Ore19095/trabajo_de_graduacion/trabajo_de_graduación/n-anexos.tex

\section{Diagrama esquemático de la placa de expansión}
\label{sec:anexo_esquematico}

\begin{figure}[H]
    \centering
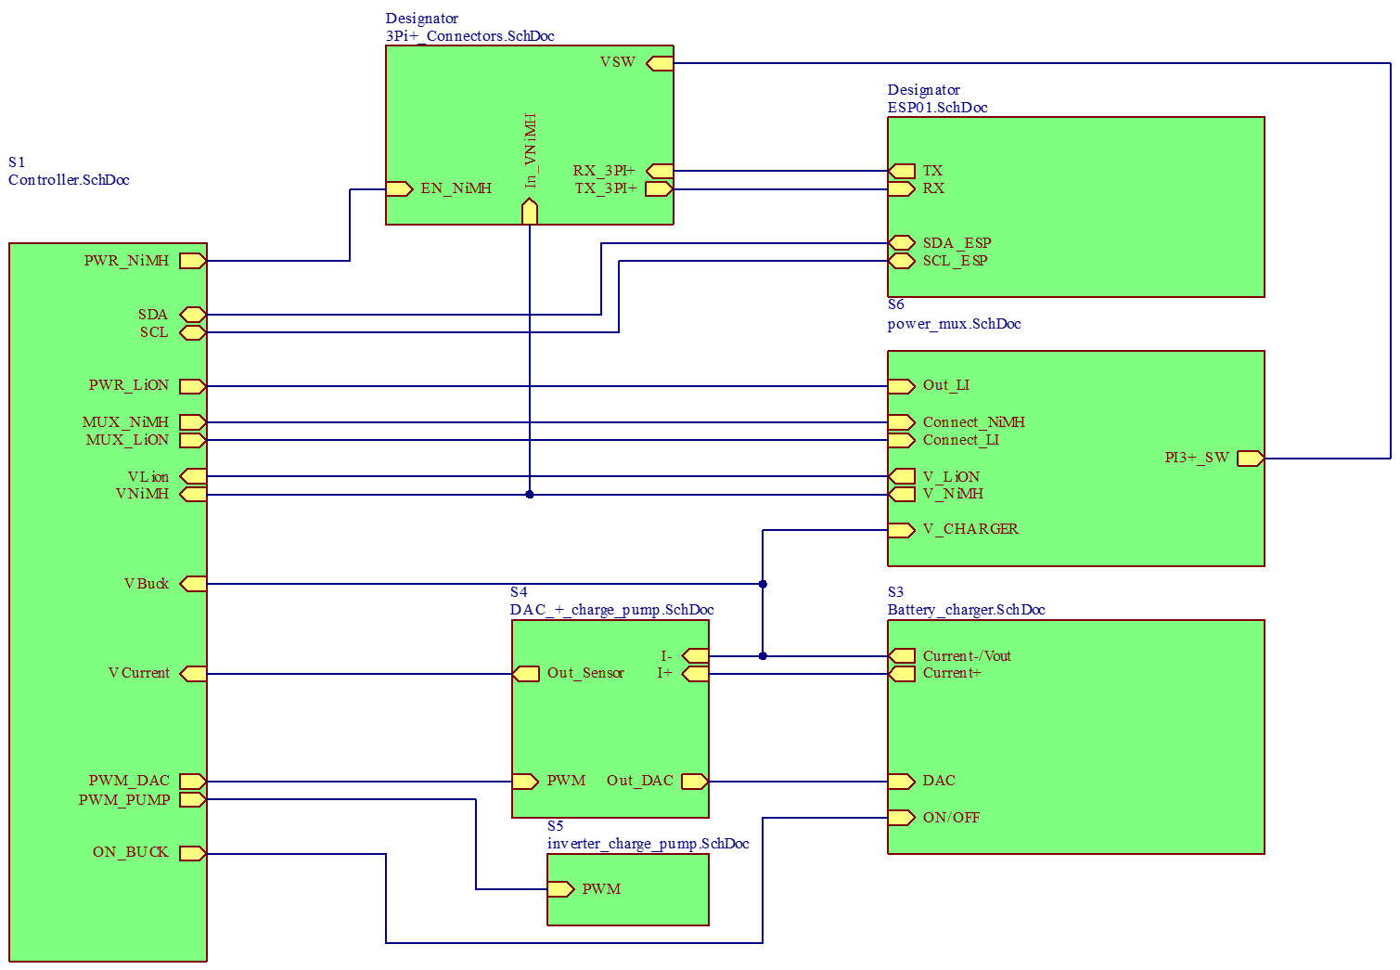
[picture p24: trabajo_de_graduación/imagenes/system_interconection.png]
    
    \caption{Interconexión de los circuitos en la placa de expansión}
    \label{fig:all}    
\end{figure}

\begin{figure}[H]
    \centering
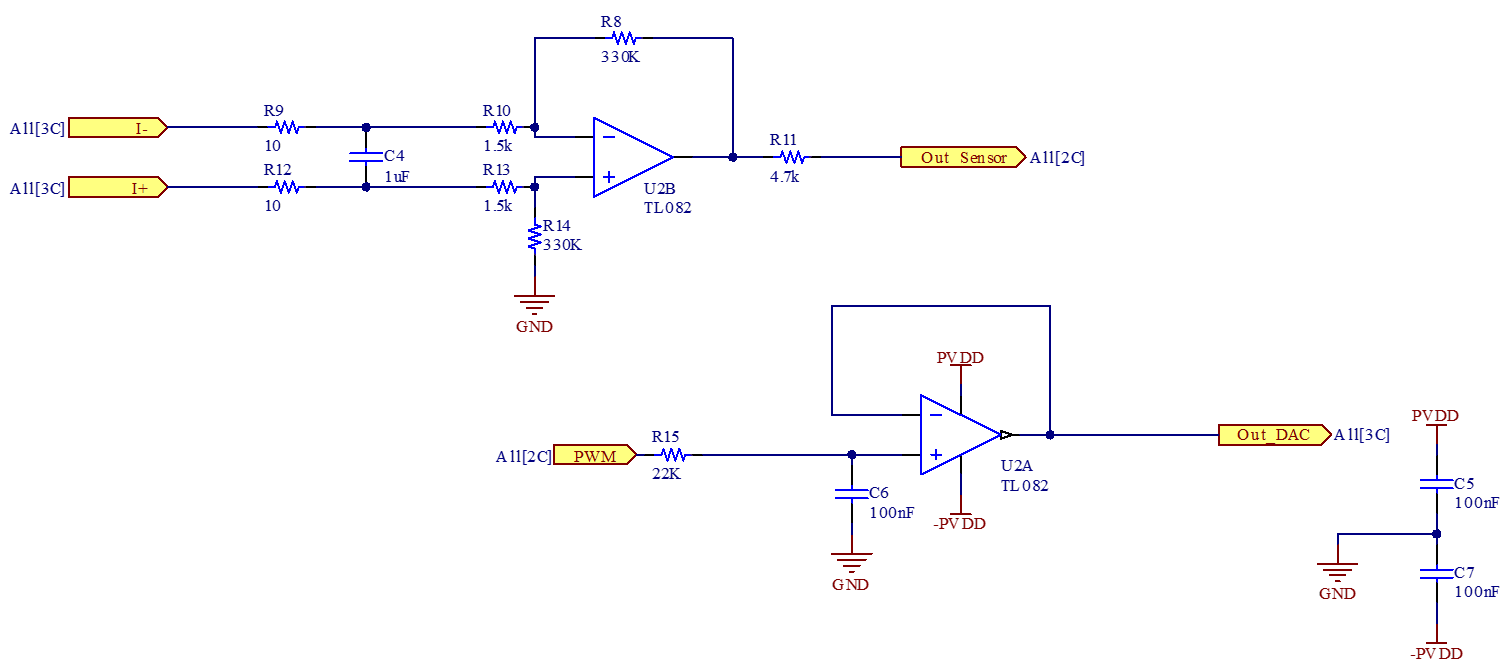
[picture p25: trabajo_de_graduación/imagenes/dac_sensor.png]
    
    \caption{Diagrama esquemático del sensor de corriente y el convertidor digital a analógico
    (S4 en la figura \ref{fig:all})}
    \label{fig:dac_sensor}
\end{figure}

\begin{figure}[H]
    \centering
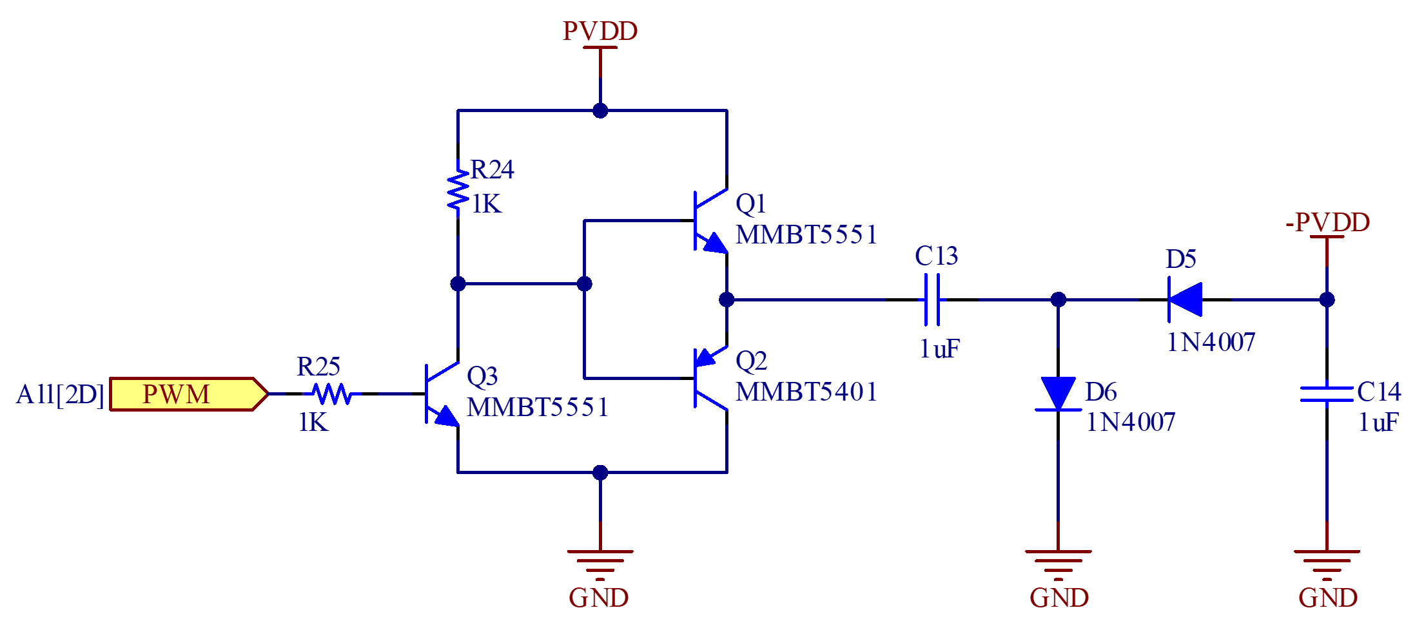
[picture p26: trabajo_de_graduación/imagenes/charge_pump.png]
    
    \caption{Diagrama esquemático del \textit{charge pump} (S5 en la figura \ref{fig:all})}
    \label{fig:charge_pump_anexo}
\end{figure}

\begin{figure}[H]
    \centering
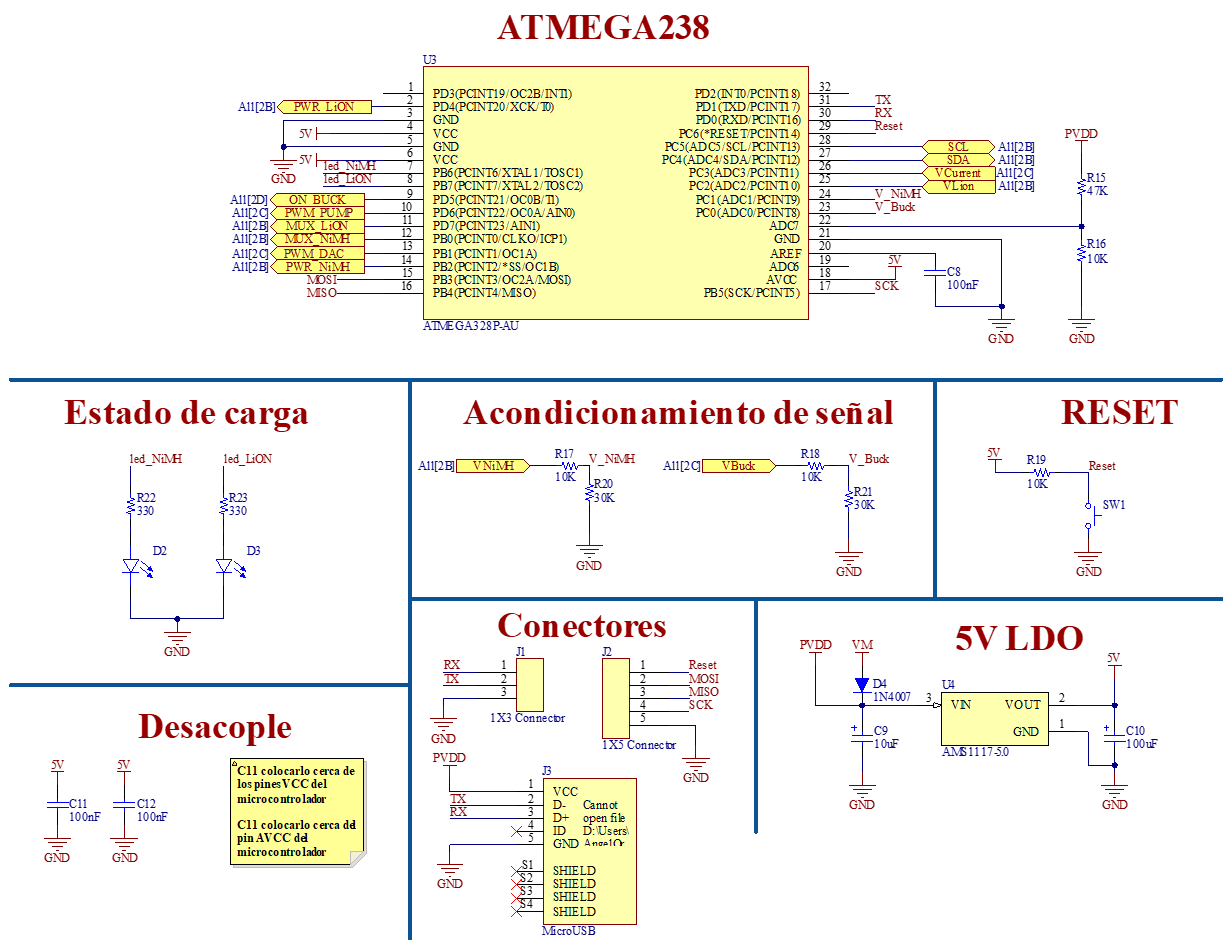
[picture p27: trabajo_de_graduación/imagenes/controlador_disenio.png]
    
    \caption{Diagrama esquemático del controlador (S1 en la figura \ref{fig:all})}
    \label{fig:controlador_anexo}
\end{figure}

\begin{figure}[H]
    \centering
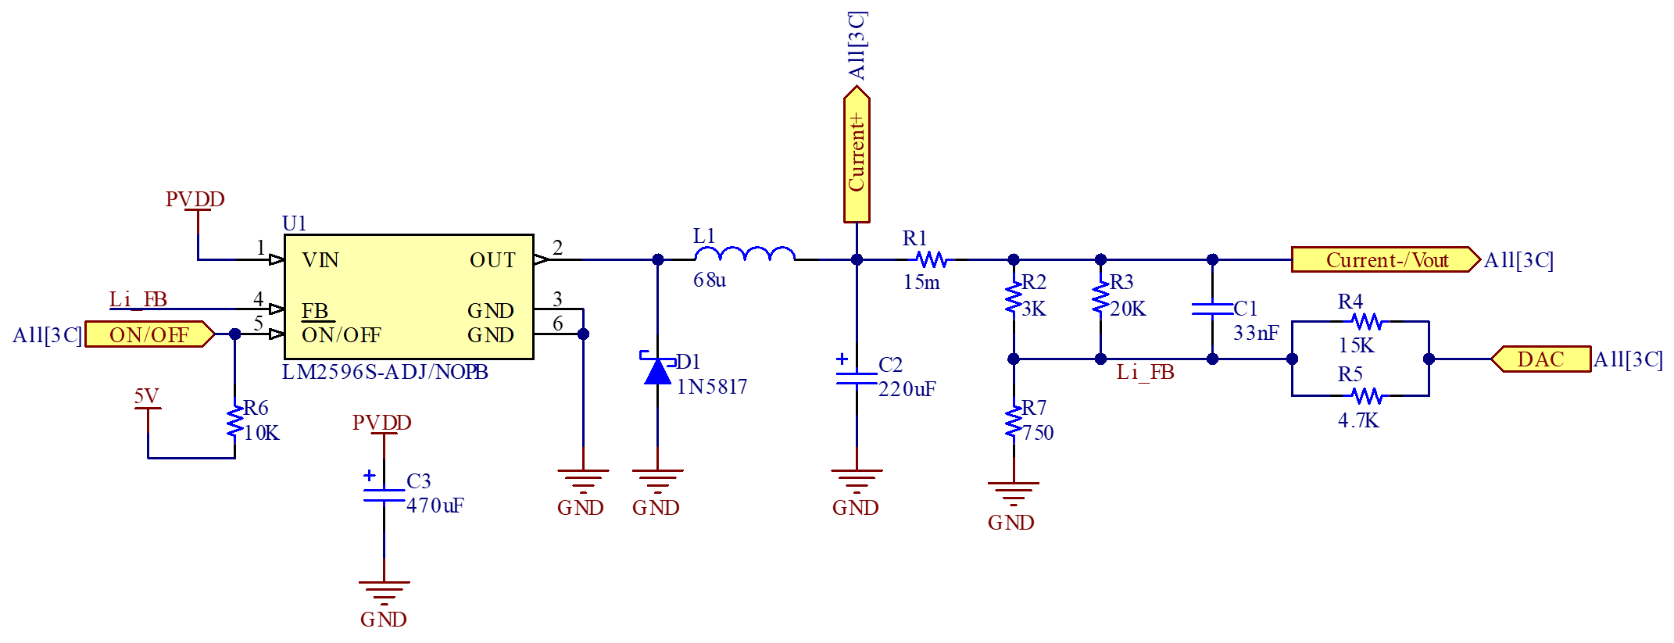
[picture p28: trabajo_de_graduación/imagenes/charger_anexos.png]
    
    \caption{Diagrama esquemático del convertidor reductor (S3 en la figura \ref{fig:all})}
    \label{fig:charger_anexo}
\end{figure}

\begin{figure}[H]
    \centering
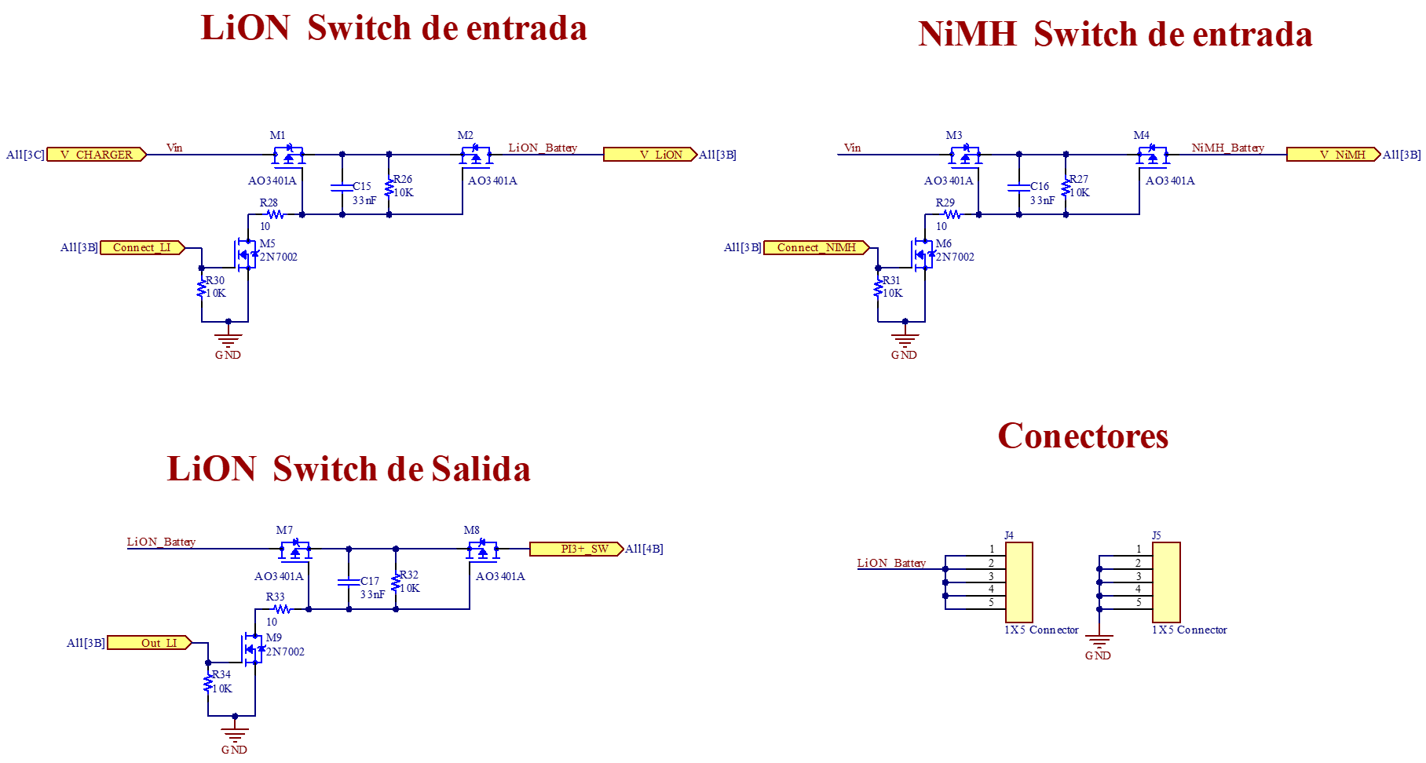
[picture p29: trabajo_de_graduación/imagenes/mux_anexo.png]
    
    \caption{Diagrama esquemático del multiplexor de potencia (S6 en la figura \ref{fig:all})}
    \label{fig:charger_anexo_mux}  
\end{figure}

\begin{figure}[H]
    \centering
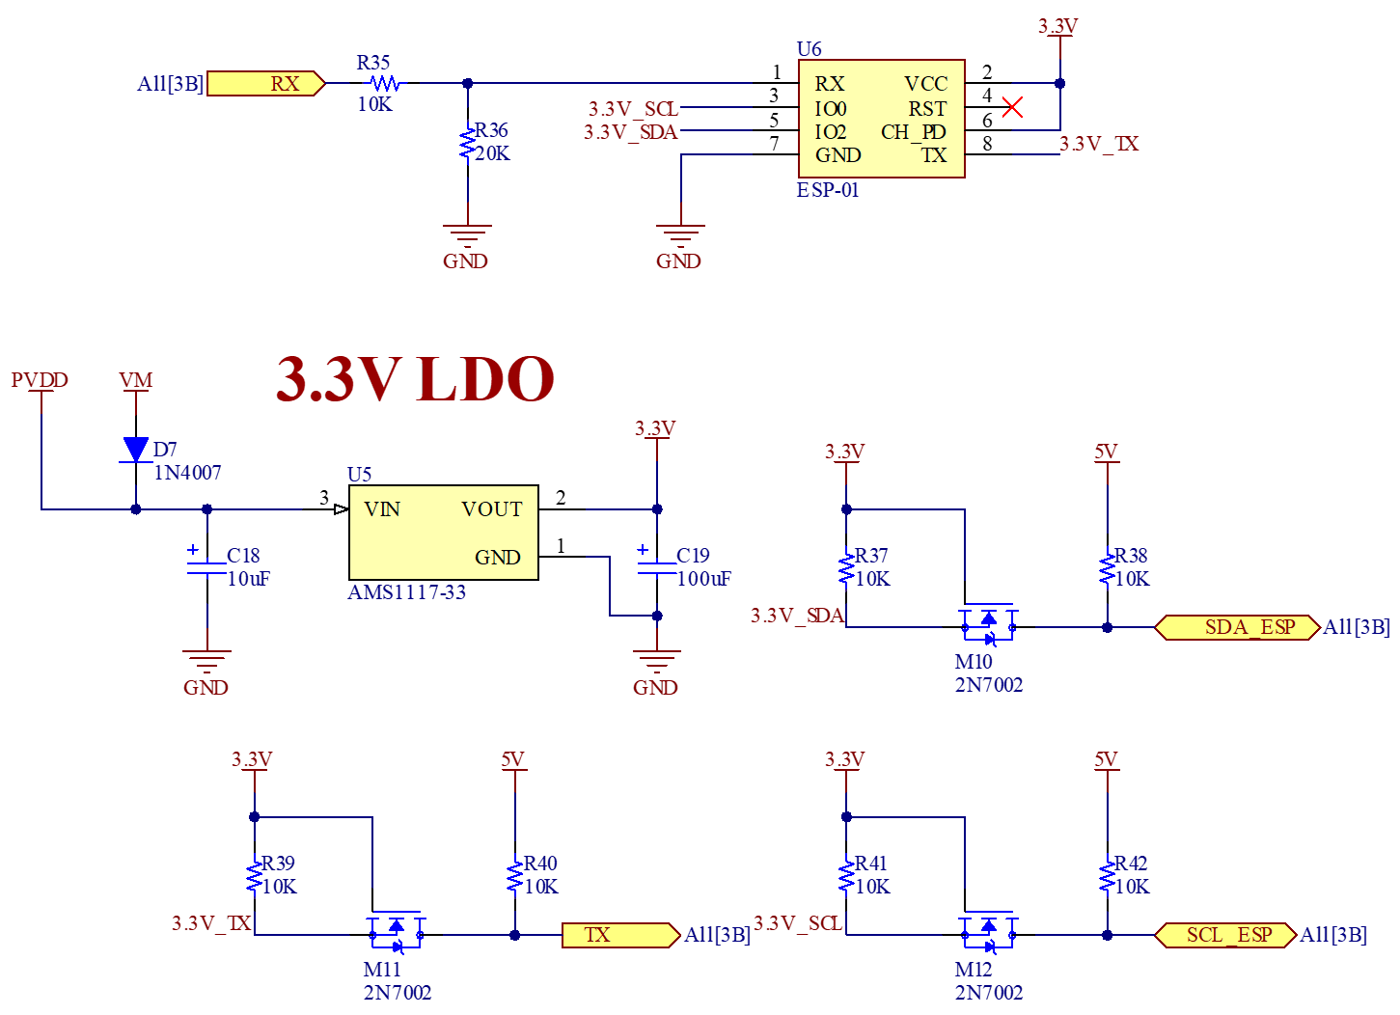
[picture p30: trabajo_de_graduación/imagenes/esp01.png]
    
    \caption{Diagrama esquemático del ESP01}
    \label{fig:esp01_anexo}
\end{figure}

\begin{figure}[H]
    \centering
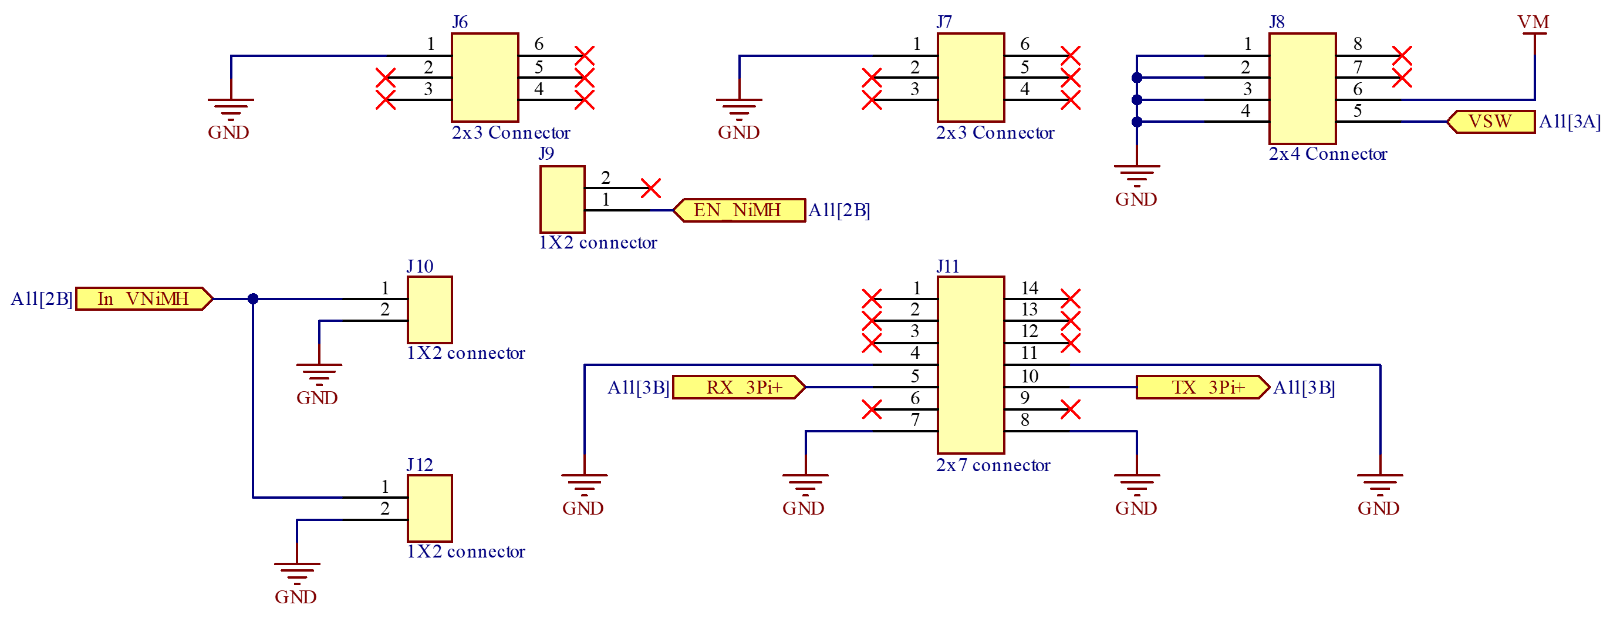
[picture p31: trabajo_de_graduación/imagenes/3pi+_anexo.png]
    
    \caption{Diagrama esquemático para los conectores del 3Pi+}
    \label{fig:3pi+_anexo}
\end{figure}

\section{Código fuente empleado en la prueba del DAC}

\label{sec:codigo_dac}

\lstinputlisting[style=atmega328]{../Charge_system_firmware/DAC_test.X/main.c}
\begin{table}[H]
    \caption{Código para prueba de funcionamiento del DAC}
\end{table}

\section{Código fuente empleado en la prueba de funcionamiento de la placa de expansión}
\label{sec:codigo_prueba_expansion}
\lstinputlisting[style=atmega328]{../Charge_system_firmware/Pololu_on_test.X/mian.c}
\begin{table}[H]
    \caption{Código para prueba de funcionamiento de la placa de expansión}
\end{table}

\section{Código fuente para el sistema de carga}
\label{sec:codigo_expansion}

\lstinputlisting[style=atmega328]{../Charge_system_firmware/Charging_system.X/main.c}
\begin{table}[H]
    \caption{Código para el sistema de carga}
\end{table}
