Ore19095/trabajo_de_graduacion/trabajo_de_graduación/sistema_carga_multiplicador_voltaje.tex

\section{Multiplicador de Voltaje}

    Debido a que el sensor de corriente y el DAC diseñados necesitan una
    alimentación simétrica de $\pm 7\text{V}$ (como mínimo), se diseñó 
    un multiplicador de voltaje basado en el circuito \textit{negative 
    Dickson charge pump} presentado en la sección \ref{sec:charge_pump}.

    \subsection{Señal de entrada del multiplicador de voltaje}
    
    Puesto que el multiplicador de voltaje necesita de una señal cuadrada, se utilizó un inversor
    elaborado con un transistor BJT, en cascada con una etapa de salida 
    \textit{push-pull}. El inversor es empleado para generar una señal
    cuadrada de amplitud $12\text{V}$ a partir de una señal cuadrada 
    de $5\text{V}$, mientras que la etapa \textit{push-pull}
    es utilizada para aumentar la corriente de salida del inversor, de forma
    que sea capaz de alimentar el multiplicador de voltaje. El circuito
    se muestra en la figura \ref{fig:inversor}.
    
    \begin{figure}[H]
        \centering
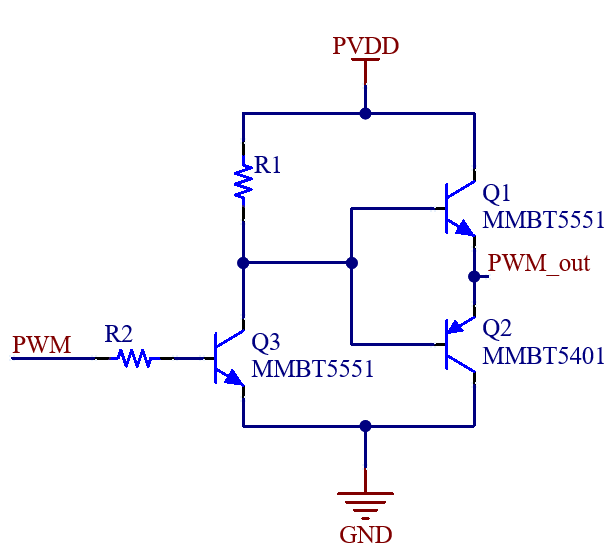
[picture p43: trabajo_de_graduación/imagenes/clk_gen.png]
        
        \caption{Inversor utilizado para generar la señal cuadrada}
        \label{fig:inversor}
    \end{figure}

    Para determinar los valores de $R_1$ y $R_2$
    se asumió que el voltaje entre base y emisor ($v_{be}$) del transistor $Q_3$
    es de $1\text{V}$  y que la ganancia en corriente del 
    transistor $Q_3$ es de $10$ \cite{mmtb5551}. Con lo anterior, se fijó el 
    valor de $R_2$ en $1\text{K}\Omega$, por 
    lo que la corriente en la base de $Q_3$ es de $I_b = 4\text{mA}$, y el valor
     esperado para la corriente de colector es de $I_c = 40\text{mA}$.

    Para que el transistor $Q_3$ actúe como un inversor es necesario que 
    este se encuentre alternando entre
    las regiones de corte y saturación. Para asegurar este comportamiento es necesario
    que el producto $I_cR_1$ sea mayor al voltaje en el nodo PVDD, el cual
    es de $12\text{V}$:
    
    $$
        I_cR_1 > 12\text{V}
    $$

    $$
        R_1 > \frac{12\text{V}}{40\text{mA}} = 300 \Omega
    $$

    Por lo que se utilizó un valor de $R_1 = 1\text{K}\Omega$. Esta señal es 
    pasada en la etapa \textit{push-pull} para aumentar la corriente de salida
    del inversor, así como disminuir la impedancia, de forma que sea 
    capaz de alimentar el multiplicador de voltaje.

    \subsection{Diseño del multiplicador de voltaje}

    Para el diseño del multiplicador de voltaje se estableció que la 
    el valor de $C_1$ y $C_2$ sea de
    $1\mu\text{F}$, que el valor de salida requerido debe ser menor o igual
    a $-7\text{V}$ y el número de etapas($N$) es igual a 1. En la 
    ecuación \ref{eq:dickson_charge_neg}  se toma en cuenta la
    capacitancia parásita de los diodos ($C_s$), para el diseño se asumió
    que estas capacitancias no son significativas en comparación con 
    $C_1$ y $C_2$,por lo que se asume $C_s = 0$.
    Con lo anterior, la ecuación \ref{eq:charge_pump} se simplifica a la
    ecuación \ref{eq:charge_pump_simp}. En la figura \ref{fig:charge_pump_dis}
    se muestra el circuito diseñado.

    \begin{figure}[H]
        \centering
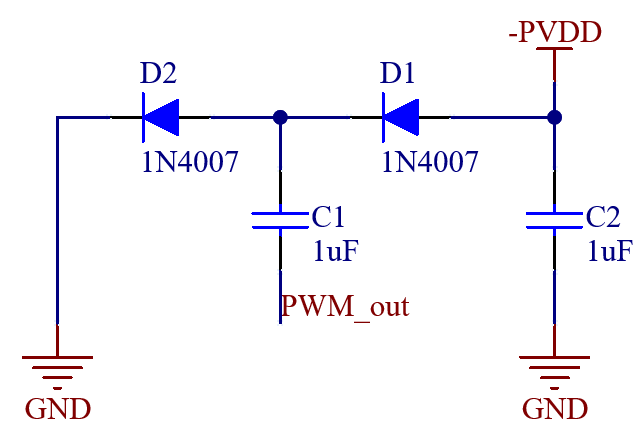
[picture p44: trabajo_de_graduación/imagenes/dickson_charge.png]
        
        \caption{Circuito diseñado para el multiplicador de voltaje}
        \label{fig:charge_pump_dis}
    \end{figure}

    \begin{equation}
        V_{out} = -\left(V_\Phi - V_D - \frac{I_{out}}{Cf}  \right) + V_D
        \label{eq:charge_pump_simp}
    \end{equation}

    Para determinar la frecuencia de operación, se utilizó la ecuación 
    \ref{eq:charge_pump_simp}, junto con la desigualdad 
    $V_{out} \leq -7\text{V}$, obteniendo la ecuación 
    \ref{eq:charge_pump_simp2}.

    \begin{equation}
        -\left(V_\Phi - V_D - \frac{I_{out}}{Cf}\right) + V_D \leq -7\text{V}
        \label{eq:charge_pump_simp2}    
    \end{equation}

    Para la amplitud de la señal cuadrada se utilizó el valor de 
    $V_\Phi = 12 \text{V}$, mientras que para 
    el valor de $V_D$ se utilizó el valor de $0.7\text{V}$, y se estimó que
    la corriente de salida del multiplicador de voltaje es de $10\text{mA}$.
    Despejando para la frecuencia se obtiene la ecuación \ref{eq:charge_pump_simp3}.

    \begin{equation}
        f \geq \frac{I_{out}}{C(V_\Phi - 2V_D - V_{out})}
        \label{eq:charge_pump_simp3}
    \end{equation}

    Reemplazando los valores estimados anteriormente en la ecuación \ref{eq:charge_pump_simp3} se obtiene
    la frecuencia de operación del multiplicador de voltaje debe de ser 

        $$
            f \geq \frac{10\text{mA}}{1\mu\text{F}(12\text{V} - (2)0.7\text{V}
             - 7\text{V})} \approx 2.778\text{KHz}
        $$

    Ya que este es un valor mínimo para la frecuencia de operación, al utilizar
    una frecuencia mayor se obtendrá un voltaje de salida mayor, por lo que se
    utilizó una frecuencia de operación de $7.81\text{KHz}$, la cual es la
    frecuencia de la señal PWM generada por el microcontrolador.

    \subsection{Prueba física del multiplicador de voltaje}

    Para comprobar el correcto funcionamiento del multiplicador de voltaje
    se añadió el multiplicador de voltaje diseñado, a los circuitos de prueba
    del DAC, el sensor de corriente  y convertidor reductor. En la figura
    \ref{fig:prueba_multiplicador} se muestra el circuito armado en protoboard.
    
    \begin{figure}[H]
        \centering
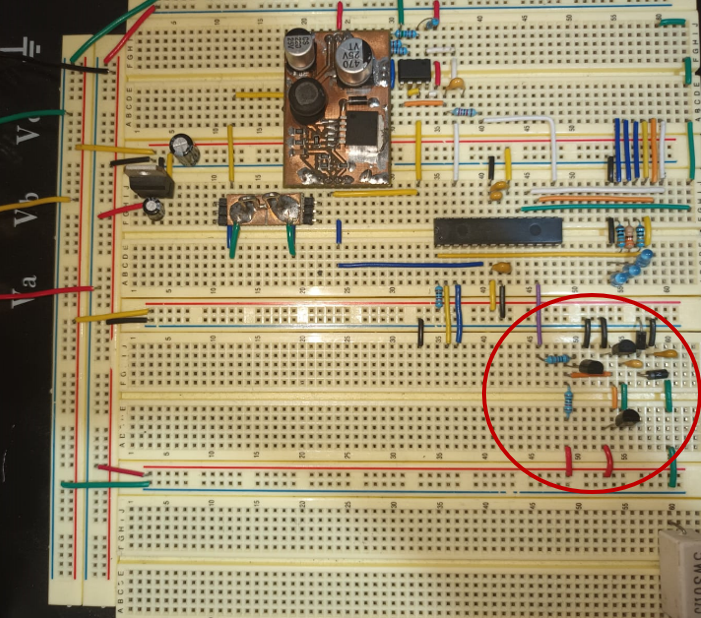
[picture p45: trabajo_de_graduación/imagenes/prueba_multiplicador.png]
        
        \caption{Circuito armado para la prueba del multiplicador de voltaje}
        \label{fig:prueba_multiplicador}
    \end{figure}

    Con el circuito armado se midió el voltaje de salida del multiplicador
    de voltaje, en las figuras \ref{fig:out_multiplicador_load} y \ref{fig:out_multiplicador_no_load}
    se muestra el voltaje de salida del multiplicador de voltaje con y sin carga,
    respectivamente.

    \begin{figure}[H]
        \centering

        \begin{subfigure}{0.45\textwidth}
            \centering
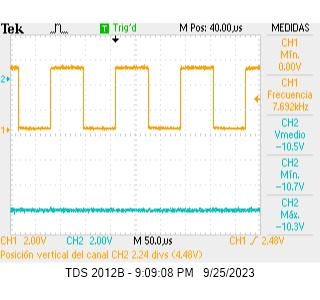
[picture p46: trabajo_de_graduación/imagenes/negative_charge_no_load.jpg]
            
            \caption{Sin carga}
            \label{fig:out_multiplicador_no_load}
        \end{subfigure}
        \begin{subfigure}{0.45\textwidth}
            \centering
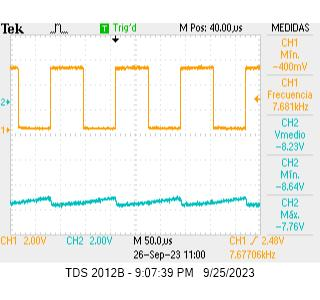
[picture p47: trabajo_de_graduación/imagenes/negative_charge_load.jpg]
            
            \caption{Con carga}
            \label{fig:out_multiplicador_load}
        \end{subfigure}
        \caption{Voltaje de salida del multiplicador de voltaje (azul, salida del multiplicador de voltaje, naranja señal cuadrada
        de entrada)}
    \end{figure}
    
    en la figura \ref{fig:out_multiplicador_no_load} se puede observar que
    el voltaje de salida del multiplicador de voltaje es de $-10.5\text{V}$ en 
    promedio, mientras que en la figura \ref{fig:out_multiplicador_load} se
    puede observar que el voltaje de salida del multiplicador de voltaje es de
    $-8.23\text{V}$ en promedio. Este resultado es el esperado, ya que el
    cuando se le coloca una carga al multiplicador de voltaje, la corriente
    de salida hace que el voltaje de salida disminuya, como es indicado en la 
    ecuación \ref{eq:charge_pump_simp}.

    Sabiendo que los diodos utilizados en el multiplicador de voltaje tienen
    una caída de voltaje de $0.7\text{V}$, se puede calcular el voltaje de
    salida del multiplicador de voltaje, utilizando la ecuación \ref{eq:charge_pump_simp}.
    Con la cual se espera que el voltaje de salida del multiplicador de voltaje
    al no haber carga sea de $-10.6\text{V}$, mientras que al haber carga, con
    una frecuencia de operación de $7.81\text{KHz}$, se espera que el voltaje
    de salida del multiplicador de voltaje sea de $-9.3\text{V}$, caso en el 
    cual se obtuvo un voltaje de $-8.23\text{V}$.
    
    La razón por la cual el voltaje de salida del multiplicador de voltaje es menor al esperado,
     es debido a varios factores: la tolerancia de los capacitores empleados, el voltaje de 
    base a colector en saturación de los transistores BJT, una mayor caída de voltaje en los diodos,
    entre otros. Sin embargo, el voltaje de salida del multiplicador de voltaje
    es suficiente para alimentar el sensor de corriente y el DAC, al ser
    menor a $-7\text{V}$, y puesto que el amplificador operacional empleado no 
    opera cerca de los valores de saturación, el ruido por conmutación
    de los transistores BJT no afecta al funcionamiento del sensor de corriente
    ni del DAC.
