Ore19095/trabajo_de_graduacion/trabajo_de_graduación/l-recomendaciones.tex

\begin{itemize}
    \item Para tener una mejor precisión en la medición de la corriente, evitar el uso
    de fuentes de voltaje negativos y reducir el espacio utilizado por el
    circuito de medición de corriente,
    se recomienda utilizar una resistencia con una menor tolerancia en empaquetado SMD, así como un 
    circuito integrado dedicado para medir corriente como lo puede ser el INA219, 
    o el INA190 de Texas Instruments.

    \item Utilizar un microcontrolador que posea un periférico de comunicación USB nativo,
    para evitar el uso de conversores USB a UART y poder hacer la placa de expansión
    compatible con protocolos de carga rápida como lo es el USB \textit{Power Delivery}, o el
    \textit{Quick Charge} de Qualcomm

    \item Emplear un circuito integrado dedicado que realice la función de 
    convertidor digital a analógico, para reducir el espacio utilizado en la placa
    de expansión, así como mejorar la precisión de la señal de voltaje para el control
    del convertidor reducir.

\end{itemize}
