Ore19095/trabajo_de_graduacion/trabajo_de_graduación/trabajo_de_graduacion_Angel_Orellana.tex

% Se pre-carga la información del estudiante sólo para poder emplear el macro de
% selección de versión (digital o impresa)
\input{0-datos_estudiante}

\ifdefined\printver
    \documentclass[11pt, letterpaper, twoside, openright]{report}
\else
    \documentclass[11pt, letterpaper]{report}
\fi

% Eliminar la opción de twoside y openright si se desea generar la versión
% digital del documento en lugar de la versión impresa
%\documentclass[11pt, letterpaper, twoside, openright]{report}
\usepackage[spanish, es-nodecimaldot, es-noquoting]{babel}
% cambiar a spanish, mexico si se quiere emplear tabla en lugar de cuadro
\selectlanguage{spanish}
\usepackage[utf8]{inputenc}
\usepackage[T1]{fontenc}

\title{Plantilla para Trabajos de Graduación IE-MT 2019v4}
\author{MSc. Miguel Zea}
\date{\today}

% Información del estudiante en el archivo datos_estudiante.tex
\input{0-datos_estudiante}
\input{1-opciones_adicionales}

% ==============================================================================
% DEFINICIÓN DE PAQUETES
% ==============================================================================
\usepackage{xcolor}
\usepackage{amsfonts}
\usepackage{amsmath}
\usepackage{amssymb}
\usepackage{amsthm}
\usepackage{amsfonts}
\usepackage{mathtools}
\usepackage{graphicx}
\usepackage{xfrac}
\usepackage{float}
\usepackage{mathtools}
\usepackage[hypertexnames=false]{hyperref}
% \usepackage{bookmark}
\usepackage[font=small]{caption}
\usepackage{subcaption}
\usepackage{csquotes}
\usepackage{xpatch}
\usepackage{emptypage}
\usepackage{hyphenat}
\usepackage{fancyhdr}
\usepackage[backend=biber, style=ieee]{biblatex}
\addbibresource{m-bibliografias.bib}

\usepackage[percent]{overpic}

\usepackage{chngcntr}

\ifdefined\CAPglosario
	%\usepackage[toc]{glossaries}
	\usepackage[numberedsection]{glossaries}
	\makeglossaries
    \input{o-glosario}
\fi

% ==============================================================================
% MÁRGENES Y FORMATO GENERALES
% ==============================================================================
\usepackage[top=1in, left=1.5in, right=1in, bottom=1in]{geometry}
%Options: Sonny, Lenny, Glenn, Conny, Rejne, Bjarne, Bjornstrup
\usepackage[Sonny]{fncychap}

% ==============================================================================
% DEFINICIONES DE LA PLANTILLA
% ==============================================================================
\graphicspath{ {figuras/} }
\definecolor{uvg-green}{RGB}{17,71,52}
\newcommand{\defaultparformat}[1]{
	{\setlength{\parskip}{2ex}
     \input{#1}}
}
\ifdefined\capsecuvg
	\renewcommand\thechapter{\Roman{chapter}}
    \renewcommand\thesection{\Alph{section}}
	\renewcommand\thesubsection{\arabic{subsection}}
    \renewcommand\thesubsubsection{\alph{subsubection}}
\fi
\counterwithout{figure}{chapter}
\counterwithout{table}{chapter}
\counterwithout{equation}{chapter}

\newcommand{\blankpage}{
\newpage
\thispagestyle{empty}
\mbox{}
\newpage
}
% ==============================================================================

% Comandos definidos por el usuario en el archivo comandos_usuario.tex
\input{2-paquetes_y_comandos_usuario}

% ==============================================================================
% CUERPO DEL TRABAJO
% ==============================================================================
\pagestyle{headings}
\begin{document}

% ==============================================================================
% PORTADA
% ==============================================================================
\ifdefined\printver
    \let\CAPportada\undefined
\fi 

\ifdefined\CAPportada
    \cleardoublepage\phantomsection
    % \pdfbookmark{Portada}{toc}
	\newgeometry{left=3cm, bottom=0in, top=1in, right=3cm}
	\pagecolor{uvg-green}
	\thispagestyle{empty}

	\color{white}
	\noindent \hrulefill \par
	\vspace{0.1in}
	\noindent \Huge \nohyphens{\titulotesis} \par
	\noindent \hrulefill \par
	\noindent
	\LARGE \nombreestudiante

	\begin{figure}[b!]
    	%\makebox[\textwidth]{\includegraphics[height=13.25cm]{plantilla/portadacit.jpg}}
    	\makebox[\textwidth]{
    		\begin{overpic}[height=13.25cm]{\imagenportada}
     		\put(63,0){}  
  			\put(64.5,2){} 
        	\end{overpic}
    	}
    	%\includegraphics[height=13.25cm]{plantilla/portadacit.jpg}
	\end{figure}
	\restoregeometry
\fi

% ==============================================================================
% PRIMERAS PÁGINAS (Carátulas más hojas de guarda)
% ==============================================================================
\ifdefined\CAPcaratula
	\newpage
    \cleardoublepage\phantomsection
    % \pdfbookmark{Carátula}{toc}
	\pagecolor{white}
	\color{black}
	\setcounter{page}{1}
	\pagenumbering{roman}
	\thispagestyle{empty}
	\begin{center}
		\LARGE UNIVERSIDAD DEL VALLE DE GUATEMALA\\
		\LARGE Facultad de \uvgfacultad \\[0.75cm]
	\end{center}
	\begin{figure}[h]
		\begin{center}
		
		\vspace{0.5in}
		\end{center}
	\end{figure}
	\begin{center}
		\Large \textbf{\nohyphens{\titulotesis}} \\
		%\LARGE \textbf{\titulotesis} \\
		\vfill
		\Large \nohyphens{Trabajo de graduación presentado por \nombreestudiante \ para optar al grado académico de Licenciado en \uvgcarrera} \\
		\vfill
		\large Guatemala, \\
		\vspace{1em}
		\anoentrega
	\end{center}
    
    \ifdefined\printver	
	    \blankpage
	    \blankpage
	    
	    \newpage
	    \cleardoublepage\phantomsection
	    \pagecolor{white}
    	\color{black}
    	\setcounter{page}{1}
    	\pagenumbering{roman}
    	\thispagestyle{empty}
    	\begin{center}
    		\LARGE UNIVERSIDAD DEL VALLE DE GUATEMALA\\
    		\LARGE Facultad de \uvgfacultad \\[0.75cm]
    	\end{center}
    	\begin{figure}[h]
    		\begin{center}
    		
    		\vspace{0.5in}
    		\end{center}
    	\end{figure}
    	\begin{center}
    		\Large \textbf{\nohyphens{\titulotesis}} \\
    		%\LARGE \textbf{\titulotesis} \\
    		\vfill
    		\Large \nohyphens{Trabajo de graduación presentado por \nombreestudiante \ para optar al grado académico de Licenciado en \uvgcarrera} \\
    		\vfill
    		\large Guatemala, \\
    		\vspace{1em}
    		\anoentrega
    	\end{center}
    \fi
\fi

% ==============================================================================
% HOJA DE FIRMAS
% ==============================================================================
\ifdefined\CAPfirmas
	\newpage
	\cleardoublepage\phantomsection
	\thispagestyle{empty}
	\vspace*{0.5in}
	\large Vo.Bo.:\\[1cm]
	\begin{center}
		(f) \rule[1pt]{4 in}{1pt}\\
		\nombreasesor
	\end{center}
	\vspace{1in}

	Tribunal Examinador:\\[1cm]
	\begin{center}
		(f) \rule[1pt]{4 in}{1pt}\\
		\nombreasesor \\[1in]
		(f) \rule[1pt]{4 in}{1pt}\\
		\nombreprimerex \\[1in]
		(f) \rule[1pt]{4 in}{1pt}\\
		\nombresegundoex
	\end{center}
	\vspace{1in}

%	Fecha de aprobación: Guatemala, \rule[1pt]{0.5 in}{1pt} de \rule[1pt]{1 in}{1pt} de \anoaprobacion.
    Fecha de aprobación: Guatemala,\diaaprobacion de \mesaprobacion de \anoaprobacion. %\diaaprobacion de \mesaprobacion de \anoaprobacion.
	\normalsize
\fi

% Comentar para formato estilo libro en la numeración de páginas (NO 
% compatible con la guía UVG 2019)
\pagestyle{plain}
% ==============================================================================
% CONTENIDO DEL TRABAJO
% ==============================================================================
% PREFACIO
% ------------------------------------------------------------------------------
\ifdefined\CAPprefacio
	\newpage
	\cleardoublepage\phantomsection
    \chapter*{Prefacio}
    \ifdefined\parpordefecto
    	\defaultparformat{a-prefacio}
    \else
    	\input{a-prefacio}
    \fi
    \addcontentsline{toc}{chapter}{Prefacio}
\fi

% ÍNDICE GENERAL
% ------------------------------------------------------------------------------
\ifdefined\CAPindice
	\newpage
    \cleardoublepage\phantomsection
	\renewcommand{\contentsname}{Índice}
    %\phantomsection
    \pdfbookmark{\contentsname}{toc}
    %\pdfbookmark{Índice}{toc}
	\tableofcontents
\fi

% LISTADO DE FIGURAS
% ------------------------------------------------------------------------------
\ifdefined\CAPfiguras
	\newpage
    \cleardoublepage\phantomsection
	\renewcommand{\listfigurename}{Lista de figuras}
	\listoffigures
	\addcontentsline{toc}{chapter}{Lista de figuras}
\fi

% LISTADO DE CUADROS
% ------------------------------------------------------------------------------
\ifdefined\CAPcuadros
	\newpage
    \cleardoublepage\phantomsection
	\renewcommand{\listtablename}{Lista de cuadros}
	\listoftables
	\addcontentsline{toc}{chapter}{Lista de cuadros}
\fi

% RESUMEN
% ------------------------------------------------------------------------------
\ifdefined\CAPresumen
	\newpage
    \cleardoublepage\phantomsection
	\chapter*{Resumen}
	\ifdefined\parpordefecto
		\defaultparformat{b-resumen}
	\else
		\input{b-resumen}
	\fi
	\addcontentsline{toc}{chapter}{Resumen}
\fi

% ABSTRACT
% ------------------------------------------------------------------------------
\ifdefined\CAPabstract
	\newpage
    \cleardoublepage\phantomsection
	\chapter*{Abstract}
	\ifdefined\parpordefecto
		\defaultparformat{c-abstract}
	\else
		\input{c-abstract}
	\fi
	\addcontentsline{toc}{chapter}{Abstract}
\fi

% INTRODUCCIÓN
% ------------------------------------------------------------------------------
\ifdefined\CAPintroduccion
	\newpage
	\cleardoublepage
	\pagenumbering{arabic}
	\setcounter{page}{1}
	\chapter{Introducción}
	\ifdefined\parpordefecto
		\defaultparformat{d-introduccion}
	\else
		\input{d-introduccion}
	\fi
\fi

% ANTECEDENTES
% ------------------------------------------------------------------------------
\ifdefined\CAPantecedentes
	\newpage
	\chapter{Antecedentes}
	\ifdefined\parpordefecto
    	\defaultparformat{e-antecedentes}
    \else
    	\input{e-antecedentes}
    \fi  
\fi

% JUSTIFICACIÓN
% ------------------------------------------------------------------------------
\ifdefined\CAPjustificacion
	\newpage
	\chapter{Justificación}
	\ifdefined\parpordefecto
		\defaultparformat{f-justificacion}
	\else
		\input{f-justificacion}
	\fi
\fi

% OBJETIVOS
% ------------------------------------------------------------------------------
\ifdefined\CAPobjetivos
	\newpage
	\chapter{Objetivos}
	\ifdefined\parpordefecto
		\defaultparformat{g-objetivos}
	\else
		\input{g-objetivos}
	\fi
\fi

% ALCANCE
% ------------------------------------------------------------------------------
\ifdefined\CAPalcance
	\newpage
	\chapter{Alcance}
	\ifdefined\parpordefecto
    	\defaultparformat{h-alcance}
    \else
    	\input{h-alcance}
    \fi 
\fi

% MARCO TEÓRICO
% ------------------------------------------------------------------------------
\ifdefined\CAPmarcoteorico
	\newpage
	\chapter{Marco teórico}
	\ifdefined\parpordefecto
		\defaultparformat{i-marco_teorico}
	\else
		\input{i-marco_teorico}
	\fi
\fi

% CAPÍTULOS
% ------------------------------------------------------------------------------
\newpage
\ifdefined\parpordefecto
	\defaultparformat{j-capitulos}
\else
	\input{j-capitulos}
\fi

% CONCLUSIONES
% ------------------------------------------------------------------------------
\ifdefined\CAPconclusiones
	\newpage
	\chapter{Conclusiones}
	\ifdefined\parpordefecto
		\defaultparformat{k-conclusiones}
	\else
		\input{k-conclusiones}
	\fi
\fi

% RECOMENDACIONES
% ------------------------------------------------------------------------------
\ifdefined\CAPrecomendaciones
	\newpage
	\chapter{Recomendaciones}
	\ifdefined\parpordefecto
		\defaultparformat{l-recomendaciones}
	\else
		\input{l-recomendaciones}
	\fi
\fi

% BIBLIOGRAFÍA
% ------------------------------------------------------------------------------
\ifdefined\CAPbibliografia
	\newpage
    \cleardoublepage\phantomsection
	\chapter{\bibname}
    \printbibliography[heading=none]
\fi

% ANEXOS
% ------------------------------------------------------------------------------
\ifdefined\CAPanexos
	\newpage
	\chapter{Anexos}
	\ifdefined\parpordefecto
		\defaultparformat{n-anexos}
	\else
		\input{n-anexos}
	\fi
\fi

% GLOSARIO
% ------------------------------------------------------------------------------
\ifdefined\CAPglosario
	\newpage
	\printglossary
\fi

\end{document}
