Ore19095/trabajo_de_graduacion/trabajo_de_graduación/h-alcance.tex

El alcance de este proyecto se enfoca en el diseño e implementación
de un sistema de carga multiquímica capaz de gestionar la recarga
de baterías de iones de litio (Li-ion) y níquel-metalhidruro (NiMH).
El objetivo principal es mejorar significativamente la autonomía del agente
robótico Pololu 3Pi+ y simplificar el proceso de carga asociado a sus baterías.

Para lograr este propósito, se llevará a cabo la implementación de algoritmos
especializados, diseñados para detectar tanto el inicio como la finalización
de los procesos de carga específicos para cada tipo de batería.

En el marco de este diseño de carga, se incluye el diseño y construcción
de una estación de carga dedicada. Esta estación deberá ser capaz
de suministrar tanto el voltaje como la corriente
requerida para el funcionamiento óptimo del sistema de carga
multiquímica mencionado anteriormente.
