Ore19095/trabajo_de_graduacion/trabajo_de_graduación/a-prefacio.tex

Quiero comenzar este trabajo de graduación expresando mi agradecimiento a
quienes han sido fundamentales en mi carrera académica. A mi familia, por su
amor, sacrificio y apoyo constante a lo largo de este camino. A mi querida
novia, Janny Garcia, por su apoyo y consejos invaluables en los momentos
difíciles. A mis amigos, en especial a Daniel Mundo, Noel Prado, Julio
Lopez, Victor Vanegas, Angelo Machorro y Saúl de León, por su amistad y aliento
inquebrantable. Este trabajo de graduación es el resultado de años de esfuerzo 
y dedicación, y cada uno de ustedes ha tenido un papel importante en mi camino 
hacia la culminación de esta etapa académica. Finalmente, quiero agradecer a mi
universidad, a mis profesores y a todos aquellos que contribuyeron a mi 
formación académica. Con gratitud, les dedico este trabajo como una muestra
 de mi aprecio y reconocimiento por su apoyo continuo.
