Ore19095/trabajo_de_graduacion/trabajo_de_graduación/g-objetivos.tex

\subsection*{Objetivo General}

Desarrollar y manufacturar un sistema de carga multiquímica inteligente para los agentes robóticos 
Pololu 3Pi+.

\subsection*{Objetivos específicos}

\begin{itemize}
    \item Desarrollar y manufacturar una placa de expansión para los 
    agentes robóticos Pololu 3Pi+, que contenga un módulo de carga multiquímica
    y manejo de potencia.
    \item Implementar un sistema de carga multiquímica que logre el manejo de 
    un banco de baterías NiMH, así como una batería de respaldo adicional Li-ion 18650.
    \item  Desarrollar e implementar un algoritmo de monitoreo y diagnóstico para el uso
    automático de la batería de respaldo y la carga automática del agente. 
    \item Desarrollar el prototipo de la estación de carga para los agentes Pololu 3Pi+.

\end{itemize}
