Ore19095/trabajo_de_graduacion/trabajo_de_graduación/imagenes/buck_control.png

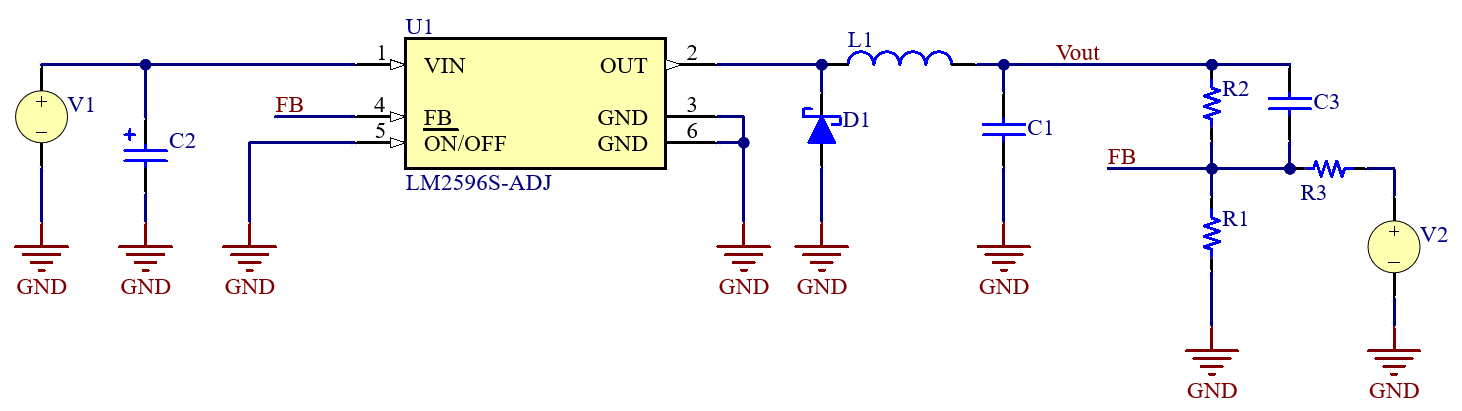
trabajo_de_graduación/imagenes/buck_control.png
