Ore19095/trabajo_de_graduacion/trabajo_de_graduación/imagenes/charger_pcb.jpg

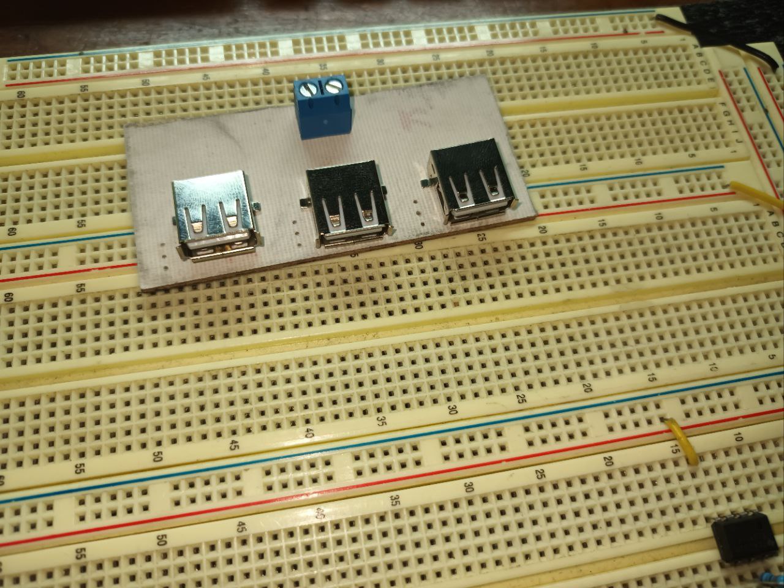
trabajo_de_graduación/imagenes/charger_pcb.jpg
