Ore19095/trabajo_de_graduacion/trabajo_de_graduación/imagenes/circuit_phis.png

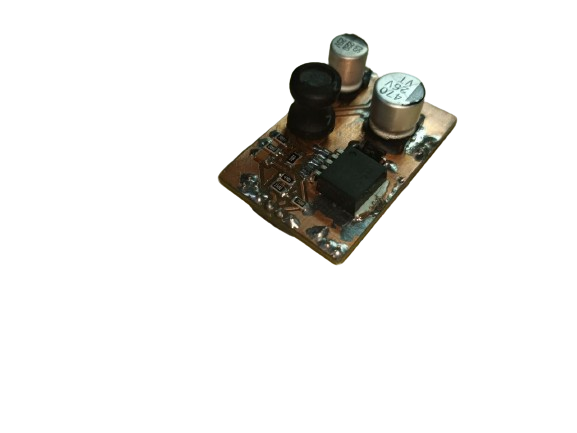
trabajo_de_graduación/imagenes/circuit_phis.png
