Ore19095/trabajo_de_graduacion/trabajo_de_graduación/imagenes/system_3d.png

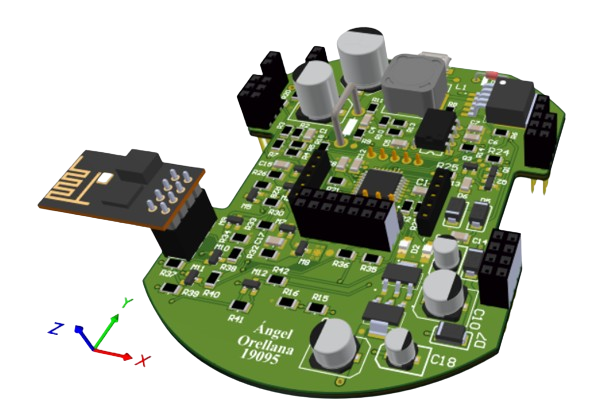
trabajo_de_graduación/imagenes/system_3d.png
