Ore19095/trabajo_de_graduacion/charging_station.3mf

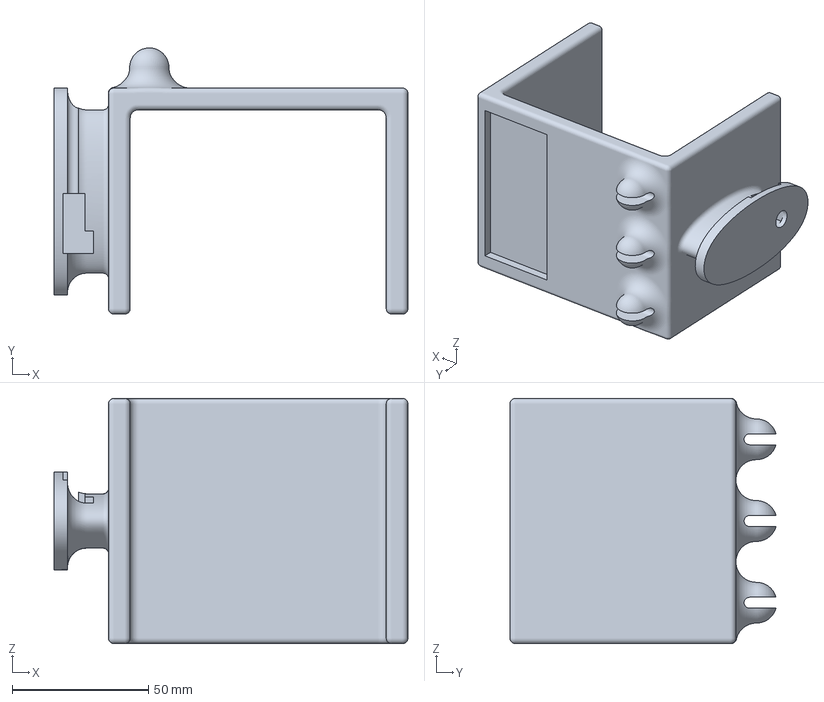
[picture p73: CAD file, 2023-11-26]
charging_station.3mf
130.0 x 97.7 x 90.0 mm
