Ore19095/trabajo_de_graduacion/PCB_Design/Battery_holde_esp32/battery.step

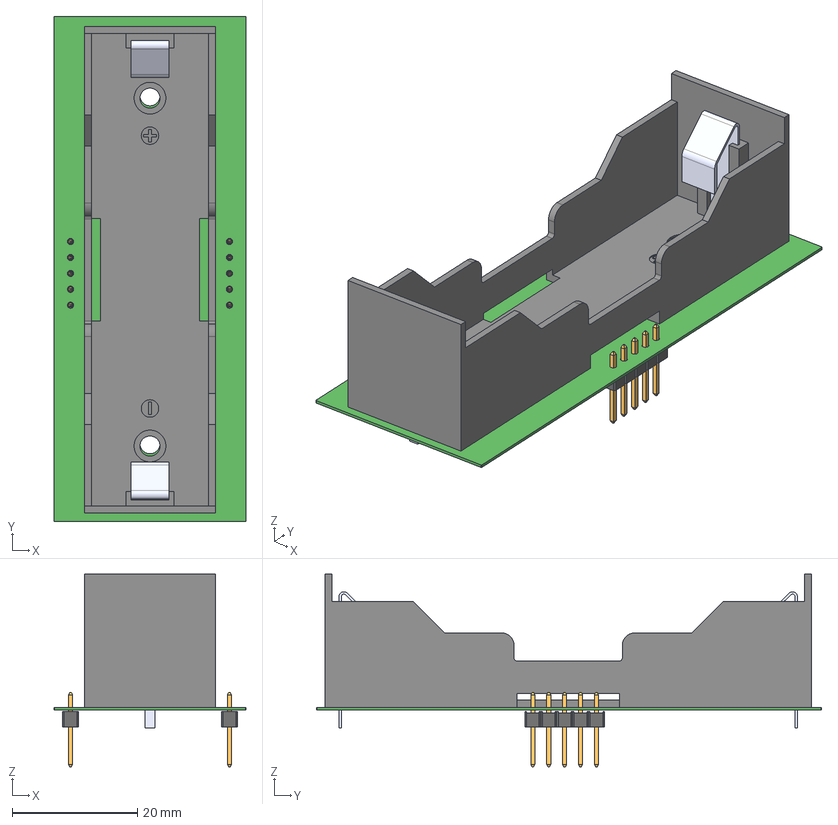
[picture p74: CAD file, 2023-09-16]
PCB_Design/Battery_holde_esp32/battery.step
30.7 x 80.7 x 30.8 mm
5-Pin Header - Male - 2.54mm x 2
BH-18650-PC--3DModel-STEP-56544
