Ore19095/trabajo_de_graduacion/trabajo_de_graduación/plantilla/escudoUVGnegro-eps-converted-to.pdf

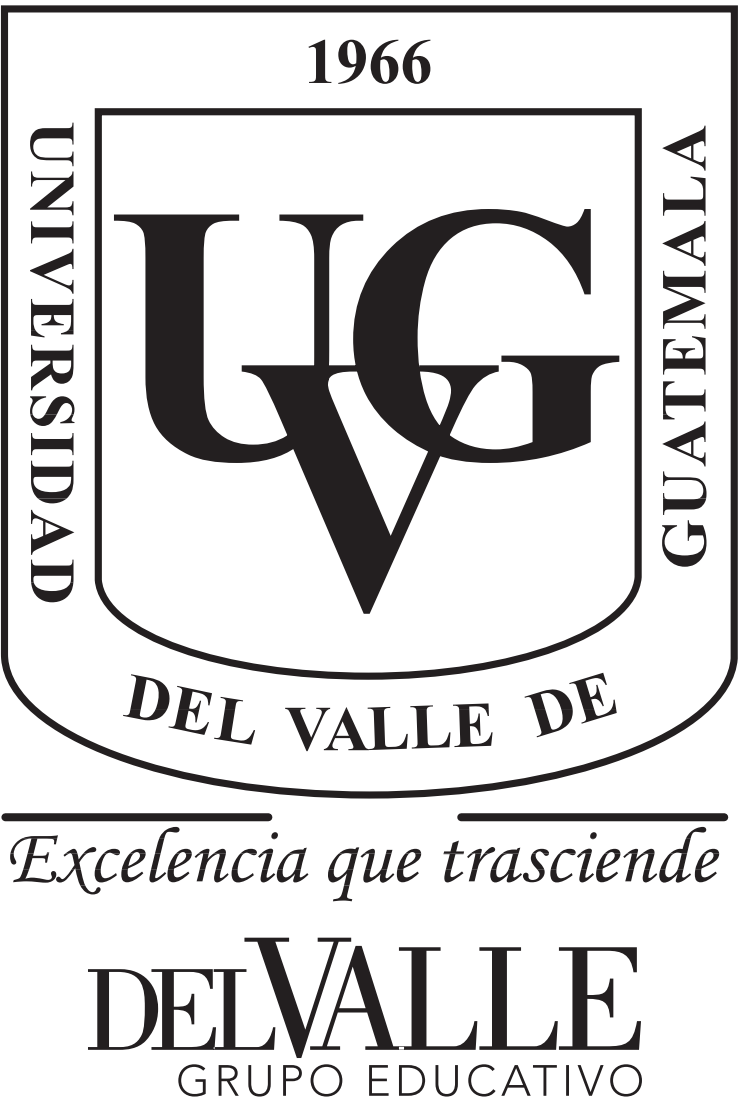
[picture p75: page 1]
