Ore19095/trabajo_de_graduacion/simulations/test_current_sensor/currentSensor.asc

Q1: pnp; TIP42C
R1: res; 470
R2: res; 0.5
R3: res; 7.5
R4: res; 1k
R5: res; 1k
R6: res; 10k
R7: res; 10k
U1: TL081
U2: TL081
V1: voltage; 6
V2: voltage; 3.75
Named nets: 0, vc
.tran 0.1
