Ore19095/trabajo_de_graduacion/simulations/cc_lm2596_data/Draft1.asc

B1: bv; V=V(Vo)
C1: cap; 33p
C2: cap; 33p
C3: cap; 10n
C4: cap; 10n
C5: cap; 1µ
D1: diode; 1N4148
L1: ind; 10µ
Q1: npn; 2N3904
R1: res; 220
R2: res; 4.7k
R3: res; 10k
R4: res; 1k
V1: voltage; SINE(1 0.1 2000)
V2: voltage; 3
Named nets: 0, Vo
.tran 0.01
