Ore19095/trabajo_de_graduacion/simulations/cc_lm2596_data/Draft2.asc

C1: cap; 10µ
C2: cap; 649.7p
C3: cap; 649.7p
C4: cap; 649.7p
Q1: npn; 2N2222
R1: res; 100
R2: res; 2.9k
R3: res; 12.33k
R4: res; 1k
R5: res; 1k
R6: res; 1k
R7: res; 1k
V1: voltage; 12
Named nets: 0, 12v
.tran 0.1
