Ore19095/trabajo_de_graduacion/simulations/cc_lm2596_data/oscilator_Phase_shift.asc

B1: bv; V=V(Vos)
C1: cap; 100µ
C2: cap; 1.3n
C3: cap; 1.3n
C4: cap; 1.3n
Q1: npn; 2N2222
Q2: pnp; 2N2907
R1: res; 80
R2: res; 4.1k
R3: res; 12.33k
R4: res; 1k
R5: res; 1k
R6: res; 500
R7: res; 500
R8: res; 1k
V1: voltage; 12
V2: voltage; SINE(0 0.29 100k)
Named nets: 0, 12v, Vos
.tran 10m
