Ore19095/trabajo_de_graduacion/simulations/filters/dac.asc

C1: cap; 100n
R1: res; 22k
U1: TL081
V1: voltage; PWL file=sine_pwm.txt
V2: voltage; 12
V3: voltage; 12
Named nets: 0, -7v, 7v, DAC
.tran 0 0.6 0
