Ore19095/trabajo_de_graduacion/simulations/filters/Draft1.asc

C1: cap; 1µ
C2: cap; 1µ
C3: cap; 1µ
C4: cap; 1µ
C5: cap; 1µ
C6: cap; 1µ
C7: cap; 1µ
C8: cap; 1µ
D1: diode; 1N4148
D2: diode; 1N4148
D3: diode; 1N4148
D4: diode; 1N4148
D5: diode; 1N4148
D6: diode; 1N4148
D7: diode; 1N4148
D8: diode; 1N4148
R1: res; 100
R2: res; 100
V1: voltage; PULSE(0 5 0 1n 1n 2m 6m)
V2: voltage; PULSE(0 5 2m 1n 1n 2m 6m)
V3: voltage; PULSE(0 5 4m 1n 1n 2m 6m)
V4: voltage; 5
V5: voltage; PULSE(0 5 0 1n 1n 3m 6m)
V6: voltage; 5
V7: voltage; PULSE(5 0 0 1n 1n 3m 6m)
Named nets: 0
.tran 1
