Ore19095/trabajo_de_graduacion/simulations/cc_lm2596_data/Bidirectional Switch.asc

C1: cap; 0.1µ
C2: cap; 0.1µ
C3: cap; 10µ
M1: pmos; AO6407
M2: pmos; AO6407
M3: nmos; Si7336ADP
M4: pmos; AO6407
M5: pmos; AO6407
M6: nmos; Si7336ADP
R1: res; 10k
R2: res; 1k
R4: res; 10k
R5: res; 1k
R6: res; 700
R7: res; 10
R8: res; 10
V1: voltage; 4.2
V2: voltage; PULSE(0 5 0 10p 10p 50m 100m)
V3: voltage; PULSE(5 0 0 10p 10p 50m 100m)
V4: voltage; 4.4
Named nets: 0
.tran 0.1
