Ore19095/trabajo_de_graduacion/simulations/cc_lm2596_data/cc_control_lm2596.asc

C1: cap; 470µ
C2: cap; 33n
D1: schottky; 1N5817
L1: ind; 68µ
R1: res; 4
R2: res; 20k
R3: res; 750
R4: res; 4.7k
R5: res; 0.25
R6: res; 3k
R7: res; 15k
U1: LM2596_ADJ
V1: voltage; 12
V2: voltage; PULSE(0 5 10m 10n 10n 10m 20m)
V3: voltage; 7
Named nets: 0, vcc, -v, Vout, V2
.tran 0.02
