Ore19095/trabajo_de_graduacion/simulations/cc_lm2596_data/negative_charge_pump.asc

C1: cap; 1µ
C2: cap; 1µ
D1: schottky; 1N5817
D2: schottky; 1N5817
Q1: npn; 2N2222
Q2: npn; 2N2222
Q3: pnp; 2N3906
R1: res; 1k
R3: res; 1k
V1: voltage; PULSE(5 0 0 10n 10n 5u 10u)
V2: voltage; 7
V3: voltage; 1
Named nets: 0
.tran 0.02
