Ore19095/trabajo_de_graduacion/simulations/CC_sources/linear_cc_source.asc

C1: cap; 100m
Q1: pnp; 2N3906
R1: res; 10k
R2: res; 1k
R3: res; 10k
R4: res; 1k
R5: res; 0.5
R6: res; 470
U1: TL081
U2: TL081
V1: voltage; 6
V2: voltage; 2.5
V3: voltage; 6
V4: voltage; 0
Named nets: 0, vcc, vcc2
.tran 0.5 startup
