Ore19095/trabajo_de_graduacion/(list of files, drawings)

Other design files:
PCB_Design/battery_charger_test/battery_charger_test.PrjPcb
PCB_Design/battery_charger_test/LI_ion_charger_test.PcbDoc
PCB_Design/battery_charger_test/multi-chemistry_charger_test.SchDoc
PCB_Design/battery_charger_with_atmega/3Pi+_Connectors.SchDoc
PCB_Design/battery_charger_with_atmega/All.SchDoc
PCB_Design/battery_charger_with_atmega/Battery_charger.SchDoc
PCB_Design/battery_charger_with_atmega/Controller.SchDoc
PCB_Design/battery_charger_with_atmega/DAC_+_charge_pump.SchDoc
PCB_Design/battery_charger_with_atmega/ESP01.SchDoc
PCB_Design/battery_charger_with_atmega/inverter_charge_pump.SchDoc
PCB_Design/battery_charger_with_atmega/Li_battery_charger_with_atmega.PrjPcb
PCB_Design/battery_charger_with_atmega/PCB_Pololu_3pi+.PrjPcb
PCB_Design/battery_charger_with_atmega/power_mux.SchDoc
PCB_Design/Battery_holde_esp32/battery.PcbDoc
PCB_Design/Battery_holde_esp32/battery.SchDoc
PCB_Design/Battery_holde_esp32/Battery_holde_esp32.PrjPcb
PCB_Design/Battery_holder/battery.PcbDoc
PCB_Design/Battery_holder/battery.SchDoc
PCB_Design/Battery_holder/Battery_holder.PrjPcb
PCB_Design/Charging_station/charging_station.PcbDoc
PCB_Design/Charging_station/Charging_station.PrjPcb
PCB_Design/Charging_station/charging_station.SchDoc
PCB_Design/Current_sensor_and_DAC/current_+_dac.SchDoc
PCB_Design/Current_sensor_and_DAC/current_sensor_+_DAC.PcbDoc
PCB_Design/Current_sensor_and_DAC/Current_sensor_and_DAC.PrjPcb
PCB_Design/imagenes_tesis/Circuitos.SchDoc
PCB_Design/imagenes_tesis/imagenes_tesis.PrjPcb
PCB_Design/lm2596_buck/charger.PcbDoc
PCB_Design/lm2596_buck/charger.SchDoc
PCB_Design/lm2596_buck/lm2596_buck.PrjPcb
PCB_Design/PCB_Pololu_3pi+/charger_pololu_3pi+.PcbDoc
PCB_Design/PCB_Pololu_3pi+/PCB_Pololu_3pi+.PrjPcb
PCB_Design/PCB_Pololu_3pi+/Sheet1.SchDoc
PCB_Design/Pmos_switch/Pmos_switch.PrjPcb
PCB_Design/Pmos_switch/switch.PcbDoc
PCB_Design/Pmos_switch/switch.SchDoc
PCB_Design/Pololu3Pi+ExpansionBoard/BatteryBoard.PcbDoc
PCB_Design/Pololu3Pi+ExpansionBoard/BoardOpenMVH7.PcbDoc
PCB_Design/Pololu3Pi+ExpansionBoard/EsquematicosPlaca3Pi+.SchDoc
PCB_Design/Pololu3Pi+ExpansionBoard/ExpansionPCB3PI+.PcbDoc
PCB_Design/Pololu3Pi+ExpansionBoard/ExpansionPCB3PI+V2.PcbDoc
PCB_Design/Pololu3Pi+ExpansionBoard/OpenMVH7Board.SchDoc
PCB_Design/Pololu3Pi+ExpansionBoard/Pololu3Pi+ExpansionBoard.PrjPcb
PCB_Design/Pololu3Pi+ExpansionBoard/ServoBoard.PcbDoc
