Ore19095/trabajo_de_graduacion/(commit log)

2023-07-12 Elementos añadidos
    [Bill of Materials-multi-chemistry_charger_test.xlsx]
2023-07-12 Cambios de ubicación en los documentos
    [Bill of Materials-multi-chemistry_charger_test.xlsx, LI_ion_charger_test.PcbDoc, battery_charger_test.PrjPcb, multi-chemistry_charger_test.SchDoc]
2023-08-13 Finished configurated gitignore
    [All.SchDoc, Battery_charger.SchDoc, Controller.SchDoc, Current_sensor.SchDoc, DAC.SchDoc, Li_battery_charger_with_atmega.PrjPcb, PCB_Pololu_3pi+.PrjPcb, charger_pololu_3pi+.PcbDoc]
2023-08-13 redaccion del diseño convertidor buck
    [Circuitos.SchDoc, imagenes_tesis.PrjPcb]
2023-08-14 Switch de potencia test terminado
    [Pmos_switch.PrjPcb, switch.PcbDoc, switch.SchDoc]
2023-09-16 Entrega 2 trabajo de graduacion
    [3Pi+_Connectors.SchDoc, All.SchDoc, BatteryBoard.PcbDoc, Battery_charger.SchDoc, Battery_holder.PrjPcb, BoardOpenMVH7.PcbDoc, Charging_station.PrjPcb, Circuitos.SchDoc]
2023-10-12 Simulación, documentación, código para DAC, finalizado
    [Controller.SchDoc, Current_sensor_and_DAC.PrjPcb, current_sensor_+_DAC.PcbDoc]
2023-10-28 Iniciando PID Voltaje/corriente
2023-11-01 TL082 drena corriente, Pin ADC no lee correctamente
    [Battery_holde_esp32.PrjPcb, Controller.SchDoc, battery.PcbDoc, battery.SchDoc, battery.step, charging_station.PcbDoc, charging_station.SchDoc]
2023-11-06 Separación de secciónes de capitulos en archivos individuales
2023-11-06 Eliminado Charge_system_firmware
2023-11-06 Charge_firmware añadido como submodulo
2023-11-26 Tesis casi terminada
    [Battery_holder.PrjPcb, battery.PcbDoc, charging_station.3mf]
2023-12-28 Envio de documento para la terna
    [Controller.SchDoc, DAC_+_charge_pump.SchDoc, ESP01.SchDoc, inverter_charge_pump.SchDoc, power_mux.SchDoc]
